lechenghhh/ContourLine/Software/FourTrekPerc/readme.md

#### 4组打击乐
可以通过四个触发输入接口来实现打击乐的输出
Perc oscillator  
base on Arduino nano 328p/168p  
for ContourLine 2.1  
作者: lecheng  
演示：https://www.bilibili.com/video/BV1vx4y1a7s7

### 音频接口:  

0.      a0:Pitch(对每个音色都有不同影响)  a1:Kick Trig  
1.      a2:Clap Trig                    a3:Tom Trig  
2.      d11:Hat Trig                    d9d10:AudioOut    

### 显示参数:  

 0.         8位数码管显示字母        参数名词EN                   参数名词CN                    参数说明
 1.         K                       Kick                        底鼓音量                      
 2.         P                       Tone                        底鼓音色
 3.         C                       Clap                        军鼓音量
 4.         F                       FreqCutoff                  军鼓截至频率                    
 5.         T                       Hat                         镲片音量                   
 6.         P                       Decay                       镲片衰减                    
 7.         H                       Rim                         小打音量                    
 8.         D                       Pitch                       小打音高
