lechenghhh/ContourLine/Hardware/v2.2 4HP/Readme.md

## Contourline2.2 4HP  
#### 更新说明  
1.改进布局与元件位号 更容易手焊 也容易排查错误  
2.优化led分压电阻封装为0603(上个版本是0402) 更容易买到也更容易焊接  
3.优化铺铜网格间隙为0.2  
4.增加-12v保护二极管 减少反接运放可能损坏情况
