lechenghhh/ContourLine/Software/FmAddChordDCO/org_change/readme.md

## 基于原版的chord/add/fm硬件与程序优化修改  
https://github.com/Testbild-synth/HAGIWO_arduino_oscillator
## 修改说明
修复p1 p2 cv输入颠倒的问题  
修复chord/add模式颠倒的问题  
优化fm算法  
优化基音为c0 使旋钮最小时不再无声
