lechenghhh/ContourLine/Hardware/v2.2 4HP/img/侧面.jpg

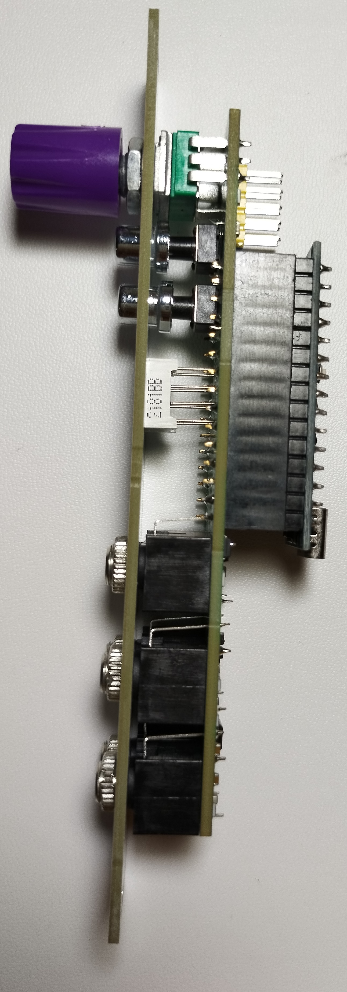
Hardware/v2.2 4HP/img/侧面.jpg
