lechenghhh/ContourLine/Hardware/v2.2 4HP/img/正面.png

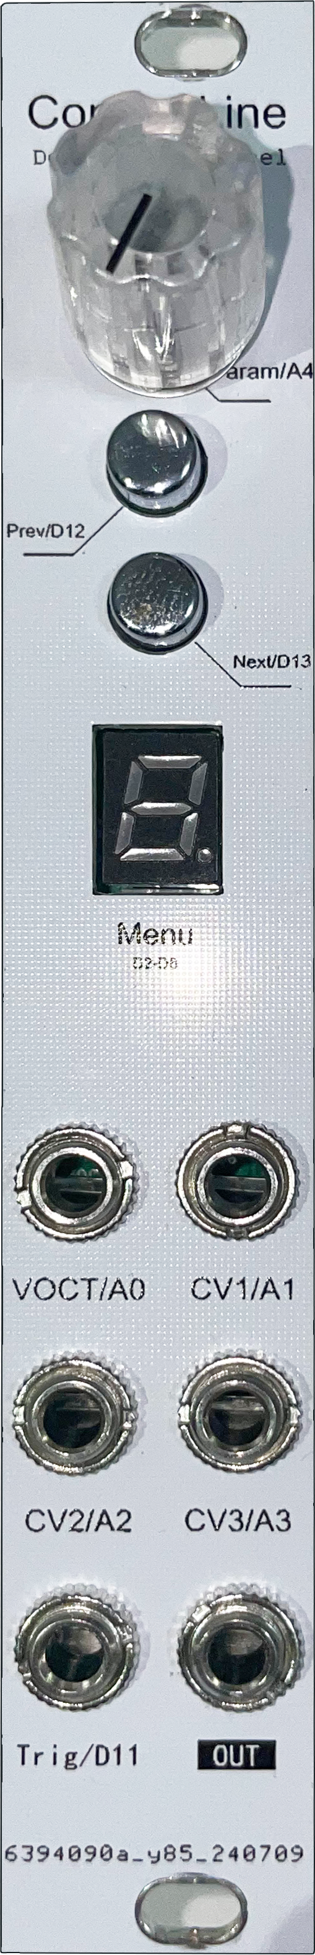
Hardware/v2.2 4HP/img/正面.png
