lechenghhh/ContourLine/Software/Avr-wt-synth/panel.png

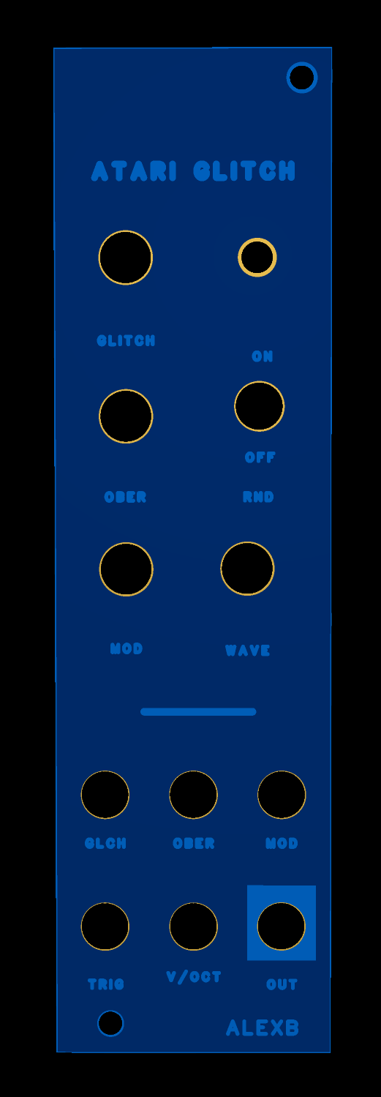
Software/Avr-wt-synth/panel.png
