lechenghhh/ContourLine/Hardware/v2.2 4HP/BOM_ContourLine2.2 4HP_ContourLine2.2 4HP_2024-07-29.xlsx

Quantity | Comment | Designator | Footprint | Value | Manufacturer Part | Primary Category | Secondary Category
1 | 100pF | C2 | R0805 | 100pF | 0805B472K500NT |  | Multilayer Ceramic Capacitors MLCC - SMD/SMT
6 | 4.7nF | C3,C4,C5,C6,C8,C11 | R0805 | 4.7nF | 0805B472K500NT | 注意 不要搞错 u和n | Multilayer Ceramic Capacitors MLCC - SMD/SMT
2 | 4.7uF | C10,C13 | R0805 | 4.7uF | 0805B472K500NT | 注意 搞错也没事就是 | Multilayer Ceramic Capacitors MLCC - SMD/SMT
10 | 1N5819 | D1,D2,D5,D6,D7,D8,D9,D10,D11,D12 | SOD-123_L2.7-W1.6-LS3.7-RD-1 | B5819W SL | B5819W SL | 二极管 | 肖特基二极管 注意封装是SOD-123
2 | 100Ω | R3,R12 | R0805 | 100Ω | 0805W8F1000T5E | Resistors | Chip Resistor - Surface Mount
5 | 470Ω | R7,R21,R104,R107,R108 | R0805 这里可以跟下面一起买0603的封装 | 470Ω | 0603WAF4700T5E | Resistors | Chip Resistor - Surface Mount
7 | 470Ω | R13,R14,R15,R16,R17,R18,R19 | R0603 | 470Ω | 0603WAF4700T5E | Resistors | Chip Resistor - Surface Mount
3 | 1kΩ | R8,R10,R11 | R0805 | 1kΩ | 0805W8F1001T5E | Resistors | Chip Resistor - Surface Mount
2 | 3.9kΩ | R1,R20 | R0805 | 3.9kΩ | 0603WAF3901T5E | Resistors | Chip Resistor - Surface Mount
1 | 47kΩ | R25 | R0805 | 47kΩ | 0805W8F4702T5E | Resistors | Chip Resistor - Surface Mount
5 | 100kΩ | R24,R101,R102,R103,R109 | R0805 | 100kΩ | 0805W8F1003T5E | Resistors | Chip Resistor - Surface Mount
1 | 330kΩ | R100 | R0805 | 330kΩ | 0603WAF3303T5E | Resistors | Chip Resistor - Surface Mount
3 | 499kΩ | R2,R105,R106 | R0805 | 499kΩ | 0805W8F1003T5E | Resistors | Chip Resistor - Surface Mount
2 | TS665CJ | U1,U2 | SW-TH_4P-L6.0-W6.0-P4.50-LS6.5 | 6x6微动开关 | TS665CJ | Key/Switch | Tactile Switches 柄选择长一些的 按钮帽可以搜索6x6 a56按钮帽 任何颜色都可以
1 | 100k | U3 | res-adj-th_rk097111080j | 10-100k 电位器都可以 | RK097111080J | Resistors | Variable Resistors/Potentiometers
1 | TL072CDT | U5 | SOIC-8_L5.0-W4.0-P1.27-LS6.0-BL | 运算放大器 | TL072CDT | 运算放大器/比较器 | FET输入运放 替代品 ne5532 lm358
6 | PJ-301f | AUDIOOUT2,CV1_A1,CV2_A2,CV3_A3,CV_OUT1,VOCT1_A0 | AUDIO-TH_PJ-301f | 音频插座 针脚 | PJ-301f | 连接器 | 音频连接器
1 | +12 | H11 | HDR-TH_10P-P2.54-V-M-R2-C5-S2.54 | 2x5p排针电源 | PZ254V-12-10P | 连接器 | 排针 2x5p排针 可以使用2个1x5p代替
1 | ARDUINO_NANO | I2 | COMM-TH_ARDUINO_NANO | 单片微控制器 | ARDUINO_NANO | 注意 需要配备排针排母 | 共约32p左右
1 | SLR0281DRA1BD | LED2 | LED-SEG-TH_8P-L7.4-W10.0-P2.54-S5.00-TL | 8位共阳数码管 | SLR0281DRA1BD | 数码管驱动/LED驱动 | LED数码管 https://item.taobao.com/item.htm?spm=a1z09.2.0.0.14a02e8dwHAgrf&id=35519235663&_u=tlnom7sc023
1 | 100nF | C9 非必要 | R0805 | 100nF 非必要 | CC0805KRX7R9BB104
 |  | 注意 电阻电容可以都买0603的
 |  | 他们仍然可以被焊接在0805的焊盘上
 |  | 也会比较容易焊接 | Note that both resistors and capacitors can be purchased from 0603, and they can still be soldered onto 0805 pads, which will also be easier to solder
