lechenghhh/ContourLine/Software/_Test/Pocket-Synth/README.md

# Pocket-Synth
Presets for a pocket sized Arduino synthesizer. Made heavy use of MOZZI library. Analog inputs were controlled by potentiometers.
