lechenghhh/ContourLine/Software/_Test/reFlector_v0.1/README.md

# reFlector
<h4>Arduino based synth and sequencer.</h4>

<em>WORK IN PROGRESS</em>

Uses primarily Mozzi library.

<br>
