lechenghhh/ContourLine/Software/_Test/FmDCOfor0.6/1位10脚数码管1.png

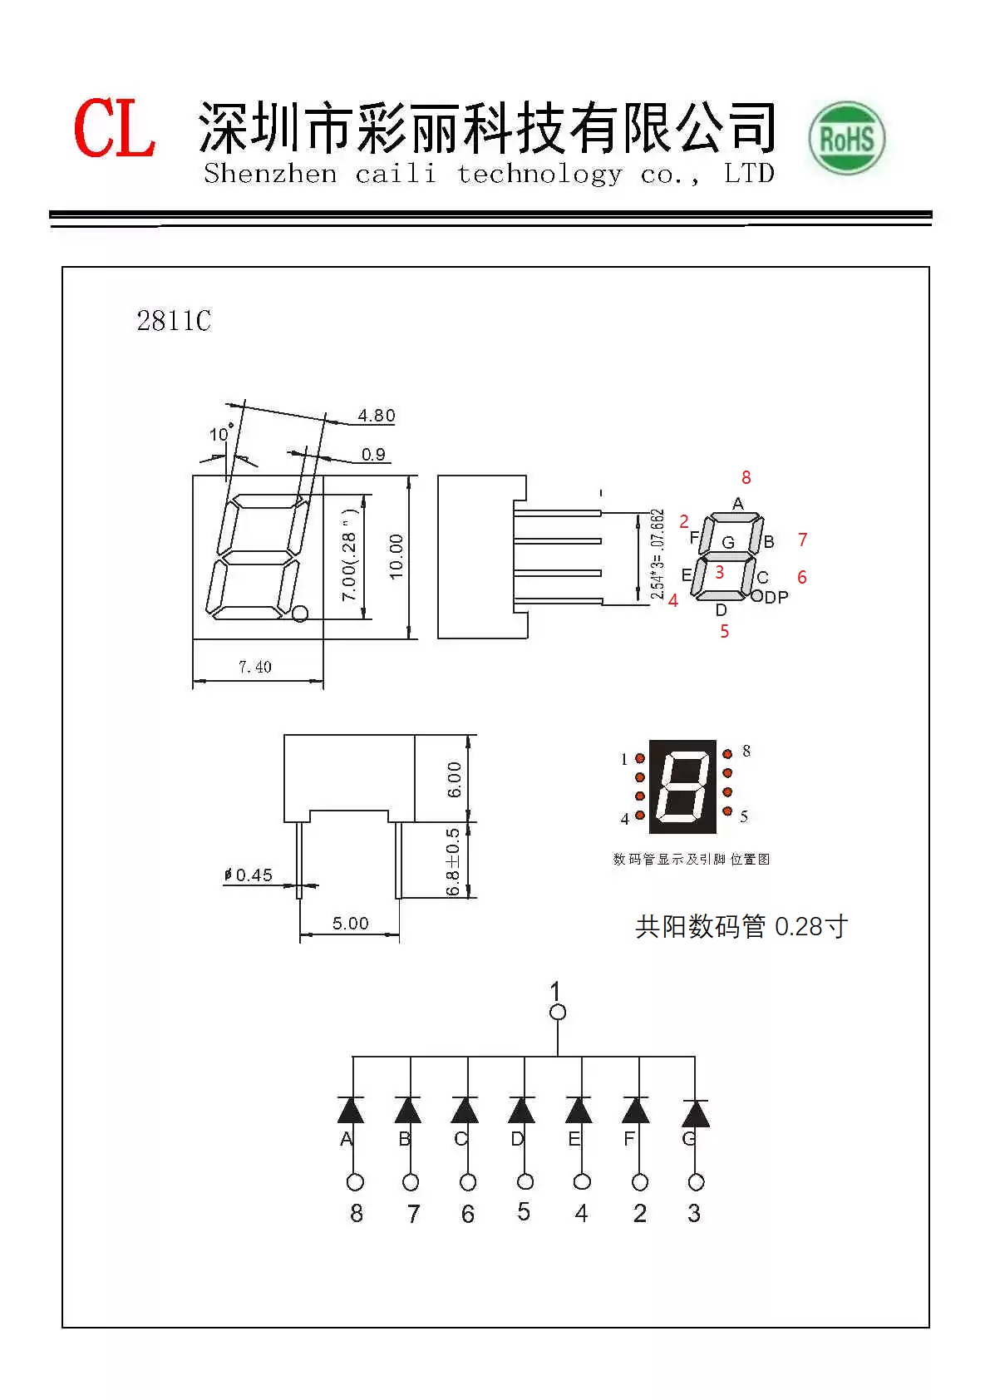
Software/_Test/FmDCOfor0.6/1位10脚数码管1.png
