lechenghhh/ContourLine/Software/_Test/pitch_covert_freq.jpg

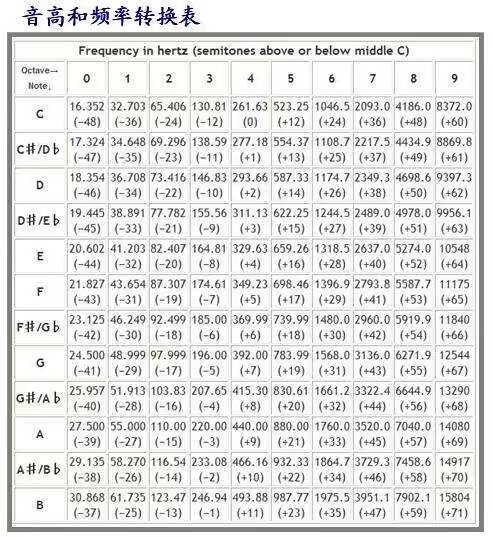
Software/_Test/pitch_covert_freq.jpg
