lechenghhh/ContourLine/Software/_Test/Test/FullFuncDCO/1bit 10pin.jpeg

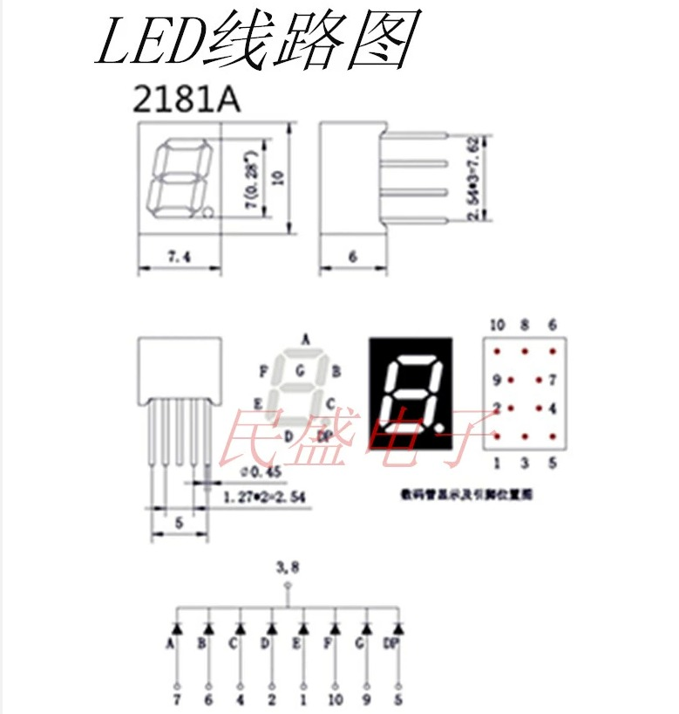
Software/_Test/Test/FullFuncDCO/1bit 10pin.jpeg
