lechenghhh/ContourLine/(threads)

Thread 1 (2024-07-04):

Trigger/Gate input: capacitor or resistor?

dlakwi, 2024-07-04:
In the v2.2 hardware design, the trigger/gate input has a capacitor C7 (100pF) from input to ground.
Shouldn't this be a resistor? Perhaps 100k?

lechenghhh, 2024-07-24:
You're right, if it's a larger resistor, it can serve as overcurrent protection

Closed 2024-07-31.
