lechenghhh/ContourLine/Software/FmAddChordDCO/FmAddChordDCO.ino

//https://github.com/Testbild-synth/HAGIWO_arduino_oscillator //项目地址
#include <Mozzi.h>
#include <Oscil.h>
#include <tables/sin2048_int8.h>
#include <tables/saw2048_int8.h>
#include <tables/triangle_hermes_2048_int8.h>
#include <tables/square_no_alias_2048_int8.h>
#include <tables/triangle_dist_cubed_2048_int8.h>
#include <FixMath.h>
#include "Module_Ctrl.h"
#include "Module_LEDDisplay.h"

#define CONTROL_RATE 64

#define V_OCT_PIN A0

// #define FREQ_PIN A0
// #define P1_POT_PIN A1
// #define P2_POT_PIN A3

#define P1_CV_PIN A1
#define P2_CV_PIN A2
// #define GAIN_CV_PIN A6
#define MODE_CV_PIN A3

#define SW_PIN_1 4
#define SW_PIN_2 5
#define LED_1_PIN 6
#define LED_2_PIN 7
#define LED_3_PIN 8
#define PARAM_LENGTH 5  // menu length

Oscil<SIN2048_NUM_CELLS, AUDIO_RATE> osc1(SIN2048_DATA);
Oscil<SIN2048_NUM_CELLS, AUDIO_RATE> osc2(SIN2048_DATA);
Oscil<SIN2048_NUM_CELLS, AUDIO_RATE> osc3(SIN2048_DATA);
Oscil<SIN2048_NUM_CELLS, AUDIO_RATE> osc4(SIN2048_DATA);
Oscil<SIN2048_NUM_CELLS, AUDIO_RATE> osc5(SIN2048_DATA);
Oscil<SIN2048_NUM_CELLS, AUDIO_RATE> osc6(SIN2048_DATA);
Oscil<SIN2048_NUM_CELLS, AUDIO_RATE> osc7(SIN2048_DATA);
Oscil<SIN2048_NUM_CELLS, AUDIO_RATE> osc8(SIN2048_DATA);

int btnHover3 = 0;  //按下事件判断
int btnTime3 = 0;   //长按事件判断

uint16_t freq_pot_val = 0;  //频率旋钮
uint16_t oct_cv_val = 0;    //voct cv
uint16_t p1_pot_val = 0;
uint16_t p1_cv_val = 0;
uint16_t p2_pot_val = 0;
uint16_t p2_cv_val = 0;
int gain_cv_val = 0;
uint8_t mode = 0;
uint8_t md_val = 0;

///additive variables
int ADD_freq1 = 110;   //base freq of OSC1
int ADD_freqv1 = 440;  // freq1 apply voct
byte ADD_gain = 127;
uint8_t ADD_harm_knob = 0;
int g1;
int g2;
int g3;
int g4;
int g5;
int g6;
int g7;
int g8;
////////

////chord variables
int freq1 = 110;  //base freq

int freqv1 = 440;  //apply voct
int freqv2 = 440;
int freqv3 = 440;
int freqv4 = 440;
int freqv5 = 440;

byte note1 = 0;  //Root
byte note2 = 0;  //2nd
byte note3 = 0;  //3rd
byte note4 = 0;  //4th
byte note5 = 0;  //Root

byte inv_aply1 = 0;  //0 = no inv , 1 = inv , Root
byte inv_aply2 = 0;  //2nd
byte inv_aply3 = 0;  //3rd
byte inv_aply4 = 0;  //4th
bool inv_aply5 = 0;  //0 = no output root sound , 1 = output root sound

int inv = 0;
int inv_knob = 0;
int chord = 0;
byte wave = 0;
////////

////FM variables
Q16n16 fm_deviation;  //偏离
Q16n16 mod_freq, knob_freq;
///////

const static byte chord_table[8][4] PROGMEM = {
  {
    0,
    68,
    119,
    205,
  },  //Maj
  {
    0,
    68,
    119,
    187,
  },  //Maj7
  {
    0,
    68,
    119,
    239,
  },  //Majadd9
  {
    0,
    34,
    119,
    205,
  },  //sus2
  {
    0,
    51,
    119,
    239,
  },  //minadd9
  {
    0,
    51,
    119,
    170,
  },  //min7
  {
    0,
    51,
    119,
    205,
  },  //min
  {
    0,
    0,
    0,
    0,
  }  //root
};

const static float voctpow[1024] PROGMEM = {
  0, 0.004882, 0.009765, 0.014648, 0.019531, 0.024414, 0.029296, 0.034179, 0.039062, 0.043945, 0.048828, 0.05371, 0.058593, 0.063476, 0.068359, 0.073242, 0.078125, 0.083007, 0.08789, 0.092773, 0.097656, 0.102539, 0.107421, 0.112304, 0.117187, 0.12207, 0.126953, 0.131835, 0.136718, 0.141601, 0.146484, 0.151367, 0.15625,
  0.161132, 0.166015, 0.170898, 0.175781, 0.180664, 0.185546, 0.190429, 0.195312, 0.200195, 0.205078, 0.20996, 0.214843, 0.219726, 0.224609, 0.229492, 0.234375, 0.239257, 0.24414, 0.249023, 0.253906, 0.258789, 0.263671, 0.268554, 0.273437, 0.27832, 0.283203, 0.288085, 0.292968, 0.297851, 0.302734, 0.307617, 0.3125, 0.317382,
  0.322265, 0.327148, 0.332031, 0.336914, 0.341796, 0.346679, 0.351562, 0.356445, 0.361328, 0.36621, 0.371093, 0.375976, 0.380859, 0.385742, 0.390625, 0.395507, 0.40039, 0.405273, 0.410156, 0.415039, 0.419921, 0.424804, 0.429687, 0.43457, 0.439453, 0.444335, 0.449218, 0.454101, 0.458984, 0.463867, 0.46875, 0.473632, 0.478515,
  0.483398, 0.488281, 0.493164, 0.498046, 0.502929, 0.507812, 0.512695, 0.517578, 0.52246, 0.527343, 0.532226, 0.537109, 0.541992, 0.546875, 0.551757, 0.55664, 0.561523, 0.566406, 0.571289, 0.576171, 0.581054, 0.585937, 0.59082, 0.595703, 0.600585, 0.605468, 0.610351, 0.615234, 0.620117, 0.625, 0.629882, 0.634765, 0.639648,
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
  { 2, 2, 2, 2, 2, 2, 2, 2, 2, 2, 2, 3, 3, 3, 4, 4, 4, 4, 5, 5, 6, 6, 7, 7, 8, 8, 8, 8, 10, 10, 10, 12, 12, 14, 14, 14, 15, 15, 15, 15, 15, 15, 16, 16, 16, 16, 16, 15, 15, 15, 15, 15, 15, 14, 14, 14, 12, 12, 10, 10, 10, 8, 8, 8, 8, 7, 7, 6, 6, 5, 5, 4, 4, 4, 4, 3, 3, 3, 2, 2, 2, 2, 2, 2, 2, 2, 2, 2, 2, 2, 2, 2, 2, 2, 2, 2, 2, 2, 2, 2, 2, 3, 3, 3, 4, 4, 4, 4, 5, 5, 6, 6, 7, 7, 8, 8, 8, 8, 10, 10, 10, 12, 12, 14, 14, 14, 15, 15, 15, 15, 15, 15, 16, 16, 16, 16, 16, 16, 15, 15, 15, 15, 15, 14, 14, 14, 12, 12, 12, 10, 10, 8, 8, 8, 8, 7, 7, 6, 6, 5, 5, 4, 4, 4, 4, 3, 3, 3, 2, 2, 2, 2, 2, 2, 2, 2, 2, 2, 2, 2, 2, 2, 2, 2, 2, 2, 2, 2, 2, 2, 2, 3, 3, 3, 4, 4, 4, 4, 5, 5, 6, 6, 7, 7, 8, 8, 8, 8, 10, 10, 10, 12, 12, 14, 14, 14, 15, 15, 15, 15, 15, 15, 16, 16, 16, 16, 16, 16, 15, 15, 15, 15, 15, 14, 14, 14, 12, 12, 12, 10, 10, 8, 8, 8, 8, 7, 7, 6, 6, 5, 5, 4, 4, 4, 4, 3 },
  { 2, 2, 2, 2, 3, 3, 3, 4, 4, 4, 4, 4, 4, 5, 5, 6, 6, 6, 7, 7, 8, 8, 8, 8, 8, 10, 10, 10, 12, 12, 14, 14, 14, 15, 15, 15, 15, 16, 16, 16, 16, 16, 16, 16, 16, 16, 16, 16, 16, 16, 16, 16, 16, 16, 16, 16, 16, 16, 16, 16, 16, 16, 15, 15, 15, 15, 14, 14, 14, 12, 12, 12, 10, 10, 8, 8, 8, 8, 8, 7, 7, 6, 6, 6, 5, 5, 4, 4, 4, 4, 4, 4, 3, 3, 3, 2, 2, 2, 2, 2, 2, 2, 2, 2, 2, 2, 2, 2, 2, 2, 2, 2, 2, 2, 2, 2, 2, 2, 2, 2, 2, 2, 2, 2, 3, 3, 3, 4, 4, 4, 4, 4, 4, 5, 5, 6, 6, 6, 7, 7, 8, 8, 8, 8, 8, 10, 10, 10, 12, 12, 14, 14, 14, 15, 15, 15, 15, 16, 16, 16, 16, 16, 16, 16, 16, 16, 16, 16, 16, 16, 16, 16, 16, 16, 16, 16, 16, 16, 16, 16, 16, 16, 16, 15, 15, 15, 14, 14, 14, 12, 12, 12, 10, 10, 8, 8, 8, 8, 8, 7, 7, 6, 6, 6, 5, 5, 4, 4, 4, 4, 4, 4, 3, 3, 3, 2, 2, 2, 2, 2, 2, 2, 2, 2, 2, 2, 2, 2, 2, 2, 2, 2, 2, 2, 2, 2, 2, 2, 2, 2, 2, 2, 2, 2, 3, 3, 3, 3, 4, 4, 4, 4, 4, 5, 5, 6 }
};

byte POSITION = 0;
char param_name[PARAM_LENGTH][5] = { "Freq", "P1", "P2", "Mode", "WaveT" };
short param[PARAM_LENGTH] = { 0, 0, 0, 0, 0 };
bool* ledGroup[PARAM_LENGTH] = { Led_F, Led_1, Led_2, Led_M, Led_W };

void setup() {
  // Serial.begin(115200);  //使用Serial.begin()函数来初始化串口波特率,参数为要设置的波特率
  startMozzi(CONTROL_RATE);
  pinMode(LED_1_PIN, OUTPUT);
  pinMode(LED_2_PIN, OUTPUT);
  pinMode(LED_3_PIN, OUTPUT);
  pinMode(SW_PIN_1, INPUT_PULLUP);
  pinMode(SW_PIN_2, INPUT_PULLUP);
  digitalWrite(SW_PIN_1, HIGH);
  digitalWrite(SW_PIN_2, HIGH);

  initCtrl(4, 50, 12, 13, HIGH);  //初始化控制参数// 旋钮 旋钮修改启动范围 按钮1 按钮2
  pinMode(2, OUTPUT);
  pinMode(3, OUTPUT);
  pinMode(4, OUTPUT);
  pinMode(5, OUTPUT);
  pinMode(6, OUTPUT);
  pinMode(7, OUTPUT);
  pinMode(8, OUTPUT);
  pinMode(11, INPUT);
  digitalWrite(11, LOW);

  osc1.setTable(SIN2048_DATA);
  osc2.setTable(SIN2048_DATA);
  osc3.setTable(SIN2048_DATA);
  osc4.setTable(SIN2048_DATA);
  osc5.setTable(SIN2048_DATA);
  osc6.setTable(SIN2048_DATA);
  osc7.setTable(SIN2048_DATA);
  osc8.setTable(SIN2048_DATA);
}

void updateControl() {
  POSITION = getPostition(POSITION, PARAM_LENGTH);  //获取菜单下标
  param[POSITION] = getParam(param[POSITION]);     //用以注册按钮旋钮控制引脚 并获取修改成功的旋钮值
  displayLED(ledGroup[POSITION]);                  //display  //用字母展示控制
  if (getKnobEnable() == 0) displayLED(Led_NULL);  //如果处在非编辑状态 led将半灭显示

  // Serial.print(" mode=");           //mode 0: FM mode 1: add, mode 2: chord
  // Serial.print(mode);               //mode
  // Serial.print(" func");            //func param
  // Serial.print(POSITION);           //func param
  // Serial.print("=");                //func param
  // Serial.println(param[POSITION]);  //func param

  read_inputs();
  mode = param[3] >> 8;  // mode 0: FM mode 1: add, mode 2: chord

  // if (p1_pot_val >= 1020) {  //inv knob max
  set_waves();
  // } else {
  if (mode == 0) {
    knob_freq = freq_pot_val;
    FM_setFreqs(knob_freq);
  } else if (mode == 1) {
    ADD_setFreqs();
  } else {
    CHORD_setFreqs();
  }
  // }
}

void read_inputs() {
  // freq_pot_val = mozziAnalogRead(FREQ_PIN);
  freq_pot_val = param[0];
  oct_cv_val = mozziAnalogRead(V_OCT_PIN);
  // p1_pot_val = mozziAnalogRead(P1_POT_PIN);
  p1_pot_val = param[1];
  p1_cv_val = mozziAnalogRead(P1_CV_PIN);
  // p2_pot_val = mozziAnalogRead(P2_POT_PIN);
  p2_pot_val = param[2];
  p2_cv_val = mozziAnalogRead(P2_CV_PIN);
  // gain_cv_val = constrain(param[3] / 2, 0, 255);
  gain_cv_val = 255;
  md_val = mozziAnalogRead(MODE_CV_PIN) / 100;
}

//
void set_waves() {
  // switch (round(p2_pot_val / 200) - 1) {
  switch (param[4] >> 7) {
    default:  //sin
      osc1.setTable(SIN2048_DATA);
      osc2.setTable(SIN2048_DATA);
      osc3.setTable(SIN2048_DATA);
      osc4.setTable(SIN2048_DATA);
      osc5.setTable(SIN2048_DATA);
      osc6.setTable(SIN2048_DATA);
      osc7.setTable(SIN2048_DATA);
      osc8.setTable(SIN2048_DATA);
      break;

    case 1:  //tri hermes
      osc1.setTable(TRIANGLE_HERMES_2048_DATA);
      osc2.setTable(TRIANGLE_HERMES_2048_DATA);
      osc3.setTable(TRIANGLE_HERMES_2048_DATA);
      osc4.setTable(TRIANGLE_HERMES_2048_DATA);
      osc5.setTable(TRIANGLE_HERMES_2048_DATA);
      osc6.setTable(TRIANGLE_HERMES_2048_DATA);
      osc7.setTable(TRIANGLE_HERMES_2048_DATA);
      osc8.setTable(TRIANGLE_HERMES_2048_DATA);
      break;

    case 2:  //tri dist
      osc1.setTable(TRIANGLE_DIST_CUBED_2048_DATA);
      osc2.setTable(TRIANGLE_DIST_CUBED_2048_DATA);
      osc3.setTable(TRIANGLE_DIST_CUBED_2048_DATA);
      osc4.setTable(TRIANGLE_DIST_CUBED_2048_DATA);
      osc5.setTable(TRIANGLE_DIST_CUBED_2048_DATA);
      osc6.setTable(TRIANGLE_DIST_CUBED_2048_DATA);
      osc7.setTable(TRIANGLE_DIST_CUBED_2048_DATA);
      osc8.setTable(TRIANGLE_DIST_CUBED_2048_DATA);
      break;

    case 3:  //saw
      osc1.setTable(SAW2048_DATA);
      osc2.setTable(SAW2048_DATA);
      osc3.setTable(SAW2048_DATA);
      osc4.setTable(SAW2048_DATA);
      osc5.setTable(SAW2048_DATA);
      osc6.setTable(SAW2048_DATA);
      osc7.setTable(SAW2048_DATA);
      osc8.setTable(SAW2048_DATA);
      break;

    case 4:  //square
      osc1.setTable(SQUARE_NO_ALIAS_2048_DATA);
      osc2.setTable(SQUARE_NO_ALIAS_2048_DATA);
      osc3.setTable(SQUARE_NO_ALIAS_2048_DATA);
      osc4.setTable(SQUARE_NO_ALIAS_2048_DATA);
      osc5.setTable(SQUARE_NO_ALIAS_2048_DATA);
      osc6.setTable(SQUARE_NO_ALIAS_2048_DATA);
      osc7.setTable(SQUARE_NO_ALIAS_2048_DATA);
      osc8.setTable(SQUARE_NO_ALIAS_2048_DATA);
      break;
  }
}

void FM_setFreqs(Q16n16 freq2) {  //freq2=knob_freq
  // Serial.print("freq2 ");
  // Serial.println(freq2);

  Q16n16 toneFreq = (2270658 + freq2 * 5000) * pow(2, (pgm_read_float(&(voctpow[oct_cv_val]))));
  // mod_freq = ((toneFreq >> 8) * ((p1_pot_val + p1_cv_val) / 2));
  // fm_deviation = (p2_pot_val + p2_cv_val) << 6;
  // osc1.setFreq_Q16n16(toneFreq);
  // osc2.setFreq_Q16n16(mod_freq);
  mod_freq = (toneFreq >> 1) * ((p1_pot_val + p1_cv_val) >> 5);      //新版倍频算法 0.5-16倍频
  fm_deviation = ((mod_freq >> 16) * (1 + p2_pot_val + p2_cv_val));  //op2amount
  osc1.setFreq_Q16n16(toneFreq);                                     //给主波形设置频率
  osc2.setFreq_Q16n16(mod_freq);
}

void ADD_setFreqs() {
  //harmonics
  // ADD_harm_knob = constrain(((p2_pot_val + p2_cv_val) / 4), 0, 255);
  ADD_harm_knob = (p2_pot_val + p2_cv_val) / 16;
  //harmonics_gain
  // ADD_gain = constrain(((p1_cv_val + p1_pot_val) / 4), 0, 255);
  ADD_gain = (p1_cv_val + p1_pot_val) / 16;
  //OSC frequency knob
  ADD_freq1 = freq_pot_val / 8;
  ADD_freqv1 = ADD_freq1 * pow(2, (pgm_read_float(&(voctpow[oct_cv_val]))));  // V/oct apply

  osc1.setFreq(ADD_freqv1);  // set the frequency
  osc2.setFreq(ADD_freqv1 * (pgm_read_byte(&(ADD_harm_table[0][ADD_harm_knob]))));
  osc3.setFreq(ADD_freqv1 * (pgm_read_byte(&(ADD_harm_table[1][ADD_harm_knob]))));
  osc4.setFreq(ADD_freqv1 * (pgm_read_byte(&(ADD_harm_table[2][ADD_harm_knob]))));
  osc5.setFreq(ADD_freqv1 * (pgm_read_byte(&(ADD_harm_table[3][ADD_harm_knob]))));
  osc6.setFreq(ADD_freqv1 * (pgm_read_byte(&(ADD_harm_table[4][ADD_harm_knob]))));
  osc7.setFreq(ADD_freqv1 * (pgm_read_byte(&(ADD_harm_table[5][ADD_harm_knob]))));
  osc8.setFreq(ADD_freqv1 * (pgm_read_byte(&(ADD_harm_table[6][ADD_harm_knob]))));

  g1 = (pgm_read_byte(&(ADD_gain_table[0][ADD_gain])) / 8);
  g2 = (pgm_read_byte(&(ADD_gain_table[1][ADD_gain])) / 8);
  g3 = (pgm_read_byte(&(ADD_gain_table[2][ADD_gain])) / 8);
  g4 = (pgm_read_byte(&(ADD_gain_table[3][ADD_gain])) / 8);
  g5 = (pgm_read_byte(&(ADD_gain_table[4][ADD_gain])) / 8);
  g6 = (pgm_read_byte(&(ADD_gain_table[5][ADD_gain])) / 8);
  g7 = (pgm_read_byte(&(ADD_gain_table[6][ADD_gain])) / 8);
  g8 = (pgm_read_byte(&(ADD_gain_table[7][ADD_gain])) / 8);
}

void CHORD_setFreqs() {
  chord = constrain((p2_pot_val / 128) + (p2_cv_val / 128), 0, 7);

  //inversion setting
  inv = constrain((p1_pot_val / 64) + (p1_cv_val / 64), 0, 15);
  switch (inv) {
    case 0:
      inv_aply1 = 0;
      inv_aply2 = 0;
      inv_aply3 = 0;
      inv_aply4 = 0;
      inv_aply5 = 0;
      break;

    case 1:
      inv_aply1 = 1;
      inv_aply2 = 0;
      inv_aply3 = 0;
      inv_aply4 = 0;
      inv_aply5 = 0;
      break;

    case 2:
      inv_aply1 = 1;
      inv_aply2 = 1;
      inv_aply3 = 0;
      inv_aply4 = 0;
      inv_aply5 = 0;
      break;

    case 3:
      inv_aply1 = 1;
      inv_aply2 = 1;
      inv_aply3 = 1;
      inv_aply4 = 0;
      inv_aply5 = 0;
      break;

    case 4:
      inv_aply1 = 1;
      inv_aply2 = 1;
      inv_aply3 = 1;
      inv_aply4 = 1;
      inv_aply5 = 0;
      break;

    case 5:
      inv_aply1 = 2;
      inv_aply2 = 1;
      inv_aply3 = 1;
      inv_aply4 = 1;
      inv_aply5 = 0;
      break;

    case 6:
      inv_aply1 = 2;
      inv_aply2 = 2;
      inv_aply3 = 1;
      inv_aply4 = 1;
      inv_aply5 = 0;
      break;

    case 7:
      inv_aply1 = 2;
      inv_aply2 = 2;
      inv_aply3 = 2;
      inv_aply4 = 1;
      inv_aply5 = 0;
      break;

    case 8:
      inv_aply1 = 2;
      inv_aply2 = 2;
      inv_aply3 = 2;
      inv_aply4 = 1;
      inv_aply5 = 1;
      break;

    case 9:
      inv_aply1 = 2;
      inv_aply2 = 2;
      inv_aply3 = 1;
      inv_aply4 = 1;
      inv_aply5 = 1;
      break;

    case 10:
      inv_aply1 = 2;
      inv_aply2 = 1;
      inv_aply3 = 1;
      inv_aply4 = 1;
      inv_aply5 = 1;
      break;

    case 11:
      inv_aply1 = 1;
      inv_aply2 = 1;
      inv_aply3 = 1;
      inv_aply4 = 1;
      inv_aply5 = 1;
      break;

    case 12:
      inv_aply1 = 1;
      inv_aply2 = 1;
      inv_aply3 = 1;
      inv_aply4 = 0;
      inv_aply5 = 1;
      break;

    case 13:
      inv_aply1 = 1;
      inv_aply2 = 1;
      inv_aply3 = 0;
      inv_aply4 = 0;
      inv_aply5 = 1;
      break;

    case 14:
      inv_aply1 = 1;
      inv_aply2 = 0;
      inv_aply3 = 0;
      inv_aply4 = 0;
      inv_aply5 = 1;
      break;

    case 15:
      inv_aply1 = 0;
      inv_aply2 = 0;
      inv_aply3 = 0;
      inv_aply4 = 0;
      inv_aply5 = 1;
      break;
  }
  //setting chord note
  note1 = (pgm_read_byte(&(chord_table[chord][0])));
  note2 = (pgm_read_byte(&(chord_table[chord][1])));
  note3 = (pgm_read_byte(&(chord_table[chord][2])));
  note4 = (pgm_read_byte(&(chord_table[chord][3])));
  note5 = (pgm_read_byte(&(chord_table[chord][0])));
  //OSC frequency knob
  freq1 = freq_pot_val / 4 + 65;
  //set wave
  if (p1_pot_val >= 1020) {  //inv knob max
    wave = (p2_pot_val / 128);
  }
  freqv1 = freq1 * pow(2, (pgm_read_float(&(voctpow[oct_cv_val + 205 * inv_aply1 + note1]))));  //ROOT
  freqv2 = freq1 * pow(2, (pgm_read_float(&(voctpow[oct_cv_val + 205 * inv_aply2 + note2]))));  //2nd
  freqv3 = freq1 * pow(2, (pgm_read_float(&(voctpow[oct_cv_val + 205 * inv_aply3 + note3]))));  //3rd
  freqv4 = freq1 * pow(2, (pgm_read_float(&(voctpow[oct_cv_val + 205 * inv_aply4 + note4]))));  //4th
  freqv5 = freq1 * pow(2, (pgm_read_float(&(voctpow[oct_cv_val + note5]))));                    //ROOT
  osc1.setFreq(freqv1);                                                                         // set the frequency
  osc2.setFreq(freqv2);
  osc3.setFreq(freqv3);
  osc4.setFreq(freqv4);
  osc5.setFreq(freqv5);
}


AudioOutput_t updateAudio() {
  if (mode == 0) {  //fm
    // return MonoOutput::fromNBit(16, (osc1.phMod(Q15n16(fm_deviation * osc2.next() >> 8)) / 2) * (gain_cv_val / 2));//old
    return MonoOutput::fromNBit(16, osc1.phMod(fm_deviation * osc2.next() >> 8) << 8);  //new
  } else if (mode == 1) {  //add   // return MonoOutput::fromNBit(16, (osc1.next() * (pgm_read_byte(&(ADD_gain_table[0][ADD_gain]))) / 512 + osc2.next() * (pgm_read_byte(&(ADD_gain_table[1][ADD_gain]))) / 512 + osc3.next() * (pgm_read_byte(&(ADD_gain_table[2][ADD_gain]))) / 512 + osc4.next() * (pgm_read_byte(&(ADD_gain_table[3][ADD_gain]))) / 512 + osc5.next() * (pgm_read_byte(&(ADD_gain_table[4][ADD_gain]))) / 512 + osc6.next() * (pgm_read_byte(&(ADD_gain_table[5][ADD_gain]))) / 512 + osc7.next() * (pgm_read_byte(&(ADD_gain_table[6][ADD_gain]))) / 512 + osc8.next() * (pgm_read_byte(&(ADD_gain_table[7][ADD_gain]))) / 512) * (gain_cv_val / 4));
    int as1 = osc1.next() * g1;
    int as2 = osc2.next() * g2;
    int as3 = osc3.next() * g3;
    int as4 = osc4.next() * g4;
    int as5 = osc5.next() * g5;
    int as6 = osc6.next() * g6;
    int as7 = osc7.next() * g7;
    int as8 = osc8.next() * g8;
    return MonoOutput::fromNBit(16, (as1 + as2 + as3 + as4 + as5 + as6 + as7 + as8));
  } else {  //chord
    return MonoOutput::fromNBit(16, ((osc1.next() / 8 + osc2.next() / 8 + osc3.next() / 8 + osc4.next() / 8 + osc5.next() / 8 * inv_aply5) * gain_cv_val));
  }
}

void loop() {
  audioHook();
}
