lechenghhh/ContourLine/Software/AnalogWave/Module_Ctrl.h

/*
  电位器 按钮 控制功能
*/

int KNOB;
int BTN1;
int BTN2;
int KNOB_CHANGE_RANGE;
int DEF_LV;

int btnHover1 = 0;   //按下事件判断1
int btnTime1 = 0;    //长按事件判断1
int btnHover2 = 0;   //按下事件判断2
int btnTime2 = 0;    //长按事件判断2
int knobEnable = 0;  //旋钮编辑状态

/*
  konbPin           旋钮模拟引脚
  konbChangeRange   旋钮启用改变的差值
  btn1Pin           按钮1数字引脚
  btn2Pin           按钮2数字引脚
  default_level     按钮默认电平
*/
void initCtrl(int konbPin, int konbChangeRange, int btn1Pin, int btn2Pin, int default_level) {
  pinMode(11, INPUT);
  digitalWrite(11, LOW);
  KNOB = konbPin;
  KNOB_CHANGE_RANGE = konbChangeRange;
  BTN1 = btn1Pin;
  BTN2 = btn2Pin;
  DEF_LV = default_level;
  if (DEF_LV == 1) {
    // pinMode(BTN2, INPUT_PULLUP);//D13引脚会因为无法上拉电阻而导致无法默认高电平 因此手动设置
    if (BTN1 == 13) digitalWrite(BTN1, HIGH);
    else pinMode(BTN1, INPUT_PULLUP);
    if (BTN2 == 13) digitalWrite(BTN2, HIGH);
    else pinMode(BTN2, INPUT_PULLUP);
  } else {
    pinMode(BTN1, INPUT);
    pinMode(BTN2, INPUT);
  }
}

/*
  传入菜单下标
  返回经过控制逻辑处理后的下标
*/
int getPostition(int position, int functionLength) {
  // Serial.println(mozziAnalogRead(KNOB));   //knob
  // Serial.println(digitalRead(BTN1));  //btn1
  // Serial.println(digitalRead(BTN2));  //btn2
  // Serial.println(btnHover1);   //btn2
  // Serial.println(btnTime1);    //btn2

  //按下事件
  if (digitalRead(BTN1) != DEF_LV) {
    btnHover1 = 1;
    btnTime1++;
  } else if (digitalRead(BTN2) != DEF_LV) {
    btnHover2 = 1;
    btnTime2++;
  }
  //抬起事件
  if (digitalRead(BTN1) == DEF_LV && btnHover1 == 1) {
    //长按按钮事件
    if (btnTime1 > 50) {
      position = 0;
      Serial.println("btn long");  //knob
    }
    //短按按钮事件
    else {
      if (position <= 0) {
        position = functionLength;
      }
      position--;
      Serial.println("btn short");  //knob
    }
    btnHover1 = 0;
    btnTime1 = 0;
    knobEnable = 0;
    Serial.println(knobEnable);  //btn2
  } else if (digitalRead(BTN2) == DEF_LV && btnHover2 == 1) {
    //长按按钮事件
    if (btnTime2 > 50) {
      position = 0;
      Serial.println("btn long 2");  //knob
    }
    //短按按钮事件
    else {
      if (functionLength - 1 <= position) {
        position = -1;
      }
      position++;
      Serial.println("btn short 2");  //knob
    }
    btnHover2 = 0;
    btnTime2 = 0;
    knobEnable = 0;
    Serial.println(knobEnable);  //btn2
  }
  return position;
}

int myread(int pin) {
  // return mozziAnalogRead(pin) / 4;  //if lgt8f328p
  return mozziAnalogRead(pin);  // if arduino nano
}

/*
  根据旧的值传入该方法判断旋钮编辑状态来返回新修改的值
*/
int getParam(int old_param) {
  // Serial.print(knobEnable);   //btn2
  // Serial.println(old_param);  //btn2
  // Serial.print("   mozziAnalogRead(KNOB) ");  //btn2
  // Serial.println(mozziAnalogRead(KNOB));      //btn2
  //旋钮事件
  int knob_dec = myread(KNOB) - old_param;  // if arduino nano  //检测旋钮进入原参数范围
  if (-KNOB_CHANGE_RANGE < knob_dec && knob_dec < KNOB_CHANGE_RANGE) {
    knobEnable = 1;
  }
  if (knobEnable == 1) {  //进入范围后 则可以调节当前参数
    old_param = myread(KNOB);
  }
  return old_param;
}

/*
  获取旋钮是否处于编辑状态 以便视图进行显示操作
*/
int getKnobEnable() {
  return knobEnable;
}
