lechenghhh/ContourLine/Software/Sampler/mysample1.h

#ifndef BAMBOO_00_4096_H_
#define BAMBOO_00_4096_H_

#include <Arduino.h>
#include "mozzi_pgmspace.h"

#define BAMBOO_00_4096_NUM_CELLS 4096
#define BAMBOO_00_4096_SAMPLERATE 16384

CONSTTABLE_STORAGE(int8_t) mysample1_DATA []  = {-1, 0, -1, 0, -1, 0, 1, 0, 0, 0, -1,
                1, 0, 0, 2, -2, -21, -66, -98, -56, 37, 60, 1, -31, 7, 72, 95, 90, 63, -1, -44,
                -72, -89, -28, 59, 92, 60, -12, -86, -125, -102, -32, 66, 123, 69, -19, -53,
                -61, -58, -20, 31, 74, 72, 6, -58, -65, -38, -9, 36, 69, 63, 22, -47, -78, -40,
                7, 36, 55, 55, 28, -22, -50, -15, 21, 21, 12, 10, 20, 12, -31, -49, -27, 0, 12,
                17, 18, 12, -16, -46, -40, -9, 9, 8, 3, 14, 9, -24, -37, -18, 2, 15, 20, 25, 28,
                4, -31, -38, -13, 19, 35, 34, 25, 4, -24, -32, -14, 21, 38, 27, 12, -3, -30,
                -48, -30, 7, 30, 28, 6, -14, -32, -41, -28, 5, 31, 28, 0, -28, -32, -22, -10, 3,
                20, 21, 2, -13, -9, 1, 5, 7, 12, 15, 10, 0, -1, 9, 11, 5, -1, 3, 13, 12, 5, 0,
                -1, -4, -10, -9, 2, 8, 5, 0, -8, -18, -24, -19, 0, 14, 10, -11, -28, -27, -16,
                -3, 8, 19, 15, 0, -14, -14, -4, 6, 14, 19, 16, 2, -14, -12, 0, 13, 20, 21, 16,
                4, -3, -5, 0, 7, 9, 2, -6, -9, -10, -10, -5, -1, -3, -8, -12, -13, -9, -8, -7,
                -4, -4, -7, -7, -4, 0, -1, -6, -8, -4, 4, 6, 6, 8, 6, 2, 2, 6, 10, 11, 14, 14,
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
-2, -3, -3, -11, -19, -18, -13, -1, 8, 10, 3, 0, -7, -5, 1, 8, 11, 15, 13, 5,
-4, -5, -1, 9, 16, 16, 12, 2, -5, -9, -4, 2, 5, 5, -1, -8, -13, -14, -13, -8, 1,
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
                                           };

#endif /* BAMBOO_00_4096_H_ */
