lechenghhh/ContourLine/Software/_Test/Test/EGFilter/EGFilter.ino

//主程序 逻辑
#include <MozziGuts.h>

#include "Module_LEDDisplay.h"  //自定义库封装led 控制 常量
#include "Module_Ctrl.h"
#include "Module_Const.h"

#include <Oscil.h>               // oscillator template
#include <tables/sin256_int8.h>  // sine table for oscillator
#include <tables/triangle_analogue512_int8.h>
#include <tables/square_no_alias512_int8.h>
#include <tables/saw256_int8.h>
#include <tables/phasor256_int8.h>
#include <tables/halfsin256_uint8.h>
#include <tables/waveshape_chebyshev_4th_256_int8.h>
#include <tables/whitenoise8192_int8.h>
#include <LowPassFilter.h>
#include <ADSR.h>
// #include <tables/sin2048_int8.h>  // sine table for oscillator

#define FUNCTION_LENGTH 10  //总菜单数
#define CONTROL_RATE 128    //控制速率
#define KNOB_PIN 0          //旋钮引脚
#define BTN1_PIN 12         //按钮引脚
#define BTN2_PIN 13         //按钮引脚
#define OUTA_PIN 11         //OUTA引脚
#define IN0_PIN 2           //V OCT
#define IN1_PIN 3           //IN1
#define IN2_PIN 5           //IN2 已经被改造为D11 用于CV输出

Oscil<SIN256_NUM_CELLS, AUDIO_RATE> aSin(SIN256_DATA);
Oscil<SIN256_NUM_CELLS, AUDIO_RATE> aLfo(SIN256_DATA);

Oscil<TRIANGLE_ANALOGUE512_NUM_CELLS, AUDIO_RATE> aTra(TRIANGLE_ANALOGUE512_DATA);
Oscil<SQUARE_NO_ALIAS512_NUM_CELLS, AUDIO_RATE> aSqu(SQUARE_NO_ALIAS512_DATA);
Oscil<SAW256_NUM_CELLS, AUDIO_RATE> aSaw(SAW256_DATA);
Oscil<PHASOR256_NUM_CELLS, AUDIO_RATE> aPha(PHASOR256_DATA);
Oscil<HALFSIN256_NUM_CELLS, AUDIO_RATE> aHSin(HALFSIN256_DATA);
Oscil<WHITENOISE8192_NUM_CELLS, AUDIO_RATE> aNos(WHITENOISE8192_DATA);
LowPassFilter lpf;
ADSR<AUDIO_RATE, AUDIO_RATE> envelope;

int POSITION = 0;  //菜单下标
String function[FUNCTION_LENGTH] = { "Wave", "F_Env", "Pitch", "Vol", "FFreq", "FltQ.", "Attk.", "Decay", "C_M_F", "C_M_A" };
int param[FUNCTION_LENGTH] = { 0, 512, 440, 1024, 972, 128, 0, 1001, 0, 0 };  // 给部分数组元素赋值

bool* ledGroup[FUNCTION_LENGTH] = { CLed1, CLed2, CLed3, CLed4, CLed5, CLed6, CLed7, CLed8, CLed7, CLed8 };

void setup() {
  Serial.begin(115200);                              //使用Serial.begin()函数来初始化串口波特率,参数为要设置的波特率
  initCtrl(KNOB_PIN, 50, BTN1_PIN, BTN2_PIN, HIGH);  //初始化控制参数
  initLED(2, 3, 4, 5, 6, 7, 8);                      //初始化led引脚
  startMozzi(CONTROL_RATE);                          //启动mozzi库
}

int Wave = 0;
int F_E_A = 0;
int F_Env = 0;
int Pitch = 0;
int Vol = 0;
int Cutof = 0;
int Reso = 0;

int C_M_F = 0;
int C_M_A = 0;
void updateControl() {

  POSITION = getPostition(POSITION, FUNCTION_LENGTH);  //获取菜单下标
  param[POSITION] = getParam(param[POSITION]);         //用以注册按钮旋钮控制引脚 并获取修改成功的旋钮值
  displayLED(ledGroup[POSITION]);                      //display  //用以展示控制

  Serial.print(function[POSITION] + param[POSITION]);  //func param
  // for (int ii = 0; ii < 10; ii++) Serial.print("-" + function[ii] + param[ii] + " ");  //func param list
  Serial.println("                  ");

  //在这里修改参数 先将1024转化成具体数值 再设置配置
  Wave = param[0] >> 7;   //波表  将1023分成8个波表类型
  Pitch = param[2] + 20;  //频率调整 20hz-2048hz
  Vol = param[3] >> 3;    //0-256
  Cutof = param[4] >> 2;
  F_Env = (param[1] >> 6) - 8;
  Reso = param[5] >> 2;
  C_M_F = param[8] >> 6;
  C_M_A = param[9] >> 6;
  aLfo.setFreq(C_M_F);

  // //设置滤波器
  // lpf.setCutoffFreq(Cutof);
  // lpf.setResonance(Reso);

  // 设置频率
  int voct = mozziAnalogRead(IN0_PIN) * 1.85;
  int toneFreq = Pitch * pow(2, (pgm_read_float(&(voctpow[voct]))));  // V/oct apply

  switch (Wave) {
    default:
      aSin.setFreq(toneFreq);  //设置频率  // aSin.setFreq(mozziAnalogRead(0));
      break;
    case 1:
      aTra.setFreq(toneFreq);  //设置频率  // aSin.setFreq(mozziAnalogRead(0));
      break;
    case 2:
      aSqu.setFreq(toneFreq);
      break;
    case 3:
      aSaw.setFreq(toneFreq);
      break;
    case 4:
      aPha.setFreq(toneFreq);
      break;
    case 5:
      aHSin.setFreq(toneFreq);
      break;
    case 6:
    case 7:
      aNos.setFreq(toneFreq);
      break;
  }
  //设置包络
  if (param[7] < 1000) {  //如果release大于1000 则启用持续震荡模式
    envelope.setADLevels(255, 255);
    envelope.setTimes(param[6] >> 4, param[7] >> 4, param[7] >> 4, param[7] >> 4);
    // if (mozziAnalogRead(IN1_PIN) > 800) //gate in
    if (digitalRead(13) == 1 || mozziAnalogRead(3) > 800)  //btn Test cltest黑色 飞线定制版
      envelope.noteOn();
    else
      envelope.noteOff();
    envelope.update();
    Vol = envelope.next() * Vol / 255;  // 这就是它与音频速率包络不同的地方
    F_E_A = Vol * F_Env;
    analogWrite(OUTA_PIN, Vol);  //对OUTA_PIN输出pwm
  }
  Serial.println(F_E_A);
}

int updateAudio() {
  // Q15n16 vibrato = (Q15n16)L1A * lfo.next();
  //设置滤波器
  lpf.setCutoffFreq(Cutof + F_E_A + (128 + aLfo.next()) * C_M_A);
  lpf.setResonance(Reso);
  switch (Wave) {
    default:
      return lpf.next((aSin.next() * Vol) >> 8);  // return an int signal centred around 0
      // int oct_cv_val = mozzimozziAnalogRead(IN2_PIN);//这里用v/oct的输入值 用mozzi专用的引脚读取 fm测试
      // return lpf.next(MonoOutput::fromNBit(16, (aSin.phMod(Q15n16(param[11] * oct_cv_val >> 8)) / 2 * Vol)));
    case 1:
      return lpf.next((aTra.next() * Vol) >> 8);
    case 2:
      return lpf.next((aSqu.next() * Vol) >> 8);
    case 3:
      return lpf.next((aSaw.next() * Vol) >> 8);
    case 4:
      return lpf.next((aPha.next() * Vol) >> 8);
    case 5:
      return lpf.next((aHSin.next() * Vol) >> 8);
    case 6:
      // return lpf.next((aCheb.next() * Vol) >> 8);
    case 7:
      return lpf.next((aNos.next() * Vol) >> 8);
  }
}

void loop() {   //这里实时音频处理 尽量不要额外的事情
  audioHook();  //Mozzi required here
}
