lechenghhh/ContourLine/Software/Sampler/sample3.h

#ifndef dongji3_H_
#define dongji3_H_
 
#include <Arduino.h>
#include "mozzi_pgmspace.h"
 
#define dongji3_NUM_CELLS 16478
#define dongji3_SAMPLERATE 4096
 
CONSTTABLE_STORAGE(int8_t) sample3_DATA [] = {9, 29, 7, 28, 7, 27, 8, 28, 10,
30, 14, 33, 18, 36, 21, 39, 24, 41, 25, 42, 25, 42, 24, 42, 23, 40, 22, 39, 20,
38, 19, 37, 19, 37, 18, 36, 18, 36, 17, 35, 16, 35, 14, 33, 12, 31, 10, 29, 7,
26, 5, 23, 2, 20, 0, 18, -2, 16, -3, 15, -3, 14, -3, 14, -3, 14, -2, 14, -2, 14,
-1, 13, -1, 13, -1, 13, -1, 12, -2, 11, -4, 9, -5, 8, -6, 7, -6, 6, -6, 6, -5,
6, -5, 5, -4, 5, -5, 3, -6, 2, -7, -1, -10, -3, -12, -6, -15, -9, -17, -12, -17,
-13, -17, -14, -17, -15, -15, -15, -14, -14, -13, -15, -13, -15, -12, -16, -12,
-17, -11, -17, -9, -16, -7, -14, -5, -12, -3, -11, -3, -10, -4, -10, -6, -12,
-9, -15, -13, -19, -16, -23, -18, -25, -19, -27, -19, -27, -17, -25, -16, -23,
-14, -21, -13, -20, -12, -19, -12, -19, -12, -20, -13, -21, -13, -22, -13, -22,
-13, -22, -12, -22, -11, -21, -9, -19, -7, -17, -5, -16, -2, -13, 1, -11, 3, -9,
6, -7, 8, -5, 10, -4, 11, -2, 12, -1, 14, 2, 16, 5, 19, 9, 23, 13, 26, 17, 29,
21, 30, 23, 30, 24, 29, 24, 26, 22, 23, 19, 21, 17, 20, 17, 22, 17, 24, 20, 29,
23, 33, 27, 37, 30, 40, 33, 42, 35, 42, 35, 40, 34, 38, 32, 36, 31, 34, 29, 33,
28, 33, 28, 33, 28, 33, 28, 32, 27, 31, 26, 28, 24, 25, 21, 21, 18, 16, 14, 12,
10, 8, 5, 4, 2, 1, -2, -1, -4, -3, -7, -4, -10, -5, -12, -5, -14, -5, -16, -5,
-18, -5, -19, -6, -20, -6, -21, -7, -22, -8, -23, -8, -24, -8, -24, -7, -23, -5,
-21, -3, -19, -1, -17, 1, -15, 2, -13, 2, -12, 1, -12, -1, -13, -3, -15, -6,
-17, -9, -19, -10, -20, -11, -21, -11, -21, -10, -21, -10, -21, -9, -21, -9,
-21, -8, -21, -7, -21, -5, -20, -2, -18, 1, -16, 4, -13, 5, -12, 5, -11, 4, -12,
1, -14, -4, -16, -8, -19, -11, -21, -14, -22, -15, -22, -15, -21, -14, -20, -13,
-18, -12, -18, -12, -18, -13, -20, -15, -23, -18, -26, -21, -30, -24, -34, -27,
-37, -30, -40, -32, -42, -33, -44, -34, -45, -34, -45, -33, -45, -32, -44, -30,
-43, -28, -42, -26, -41, -26, -40, -25, -40, -26, -39, -26, -38, -25, -37, -24,
-34, -22, -31, -19, -28, -16, -24, -14, -21, -12, -18, -11, -17, -12, -16, -13,
-17, -15, -17, -16, -17, -16, -16, -14, -14, -11, -11, -8, -7, -4, -2, 0, 1, 3,
5, 5, 7, 6, 9, 7, 10, 7, 11, 7, 12, 7, 14, 7, 16, 8, 19, 9, 21, 9, 23, 10, 25,
10, 25, 9, 25, 8, 24, 6, 23, 4, 21, 3, 20, 2, 19, 1, 19, 1, 19, 0, 19, 0, 20, 0,
20, 0, 20, 1, 21, 2, 22, 3, 24, 4, 25, 5, 27, 6, 28, 6, 29, 6, 29, 5, 29, 5, 29,
5, 29, 5, 29, 5, 29, 5, 30, 5, 30, 4, 30, 3, 29, 0, 28, -2, 26, -5, 24, -8, 22,
-10, 20, -12, 19, -12, 18, -13, 18, -13, 17, -14, 16, -15, 15, -16, 14, -16, 13,
-15, 14, -13, 16, -10, 19, -6, 22, -3, 25, -1, 27, 0, 27, -2, 25, -5, 22, -9,
18, -13, 15, -15, 12, -17, 10, -17, 10, -15, 11, -13, 12, -12, 14, -10, 14, -10,
14, -10, 13, -11, 12, -12, 11, -13, 10, -14, 9, -14, 8, -14, 7, -13, 7, -12, 7,
-10, 7, -7, 8, -4, 10, 0, 12, 4, 13, 7, 15, 10, 16, 11, 17, 13, 17, 13, 17, 14,
17, 16, 17, 18, 19, 21, 21, 24, 23, 27, 26, 29, 27, 29, 27, 28, 25, 26, 22, 23,
19, 20, 15, 18, 13, 18, 11, 19, 11, 21, 12, 23, 13, 25, 15, 27, 15, 28, 15, 28,
15, 28, 13, 27, 12, 27, 10, 26, 8, 26, 6, 26, 6, 26, 5, 25, 4, 25, 4, 23, 3, 21,
1, 18, -2, 15, -5, 11, -9, 7, -12, 3, -16, 0, -19, -2, -22, -4, -25, -6, -27,
-7, -29, -7, -31, -8, -32, -7, -33, -7, -33, -6, -33, -5, -33, -5, -33, -4, -33,
-3, -32, -2, -32, 0, -30, 2, -28, 6, -25, 9, -22, 13, -17, 17, -13, 19, -9, 21,
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
 };

#endif /* dongji3_H_ */
