lechenghhh/ContourLine/Software/Sampler/sample4.h

#ifndef sample4_H_
#define sample4_H_
 
#include <Arduino.h>
#include "mozzi_pgmspace.h"
 
#define sample4_NUM_CELLS 8286
#define sample4_SAMPLERATE 16384
 
CONSTTABLE_STORAGE(int8_t) sample4_DATA [] = {33, 51, 35, 51, 37, 50, 36, 49,
39, 47, 42, 48, 43, 52, 43, 51, 41, 46, 41, 47, 43, 48, 44, 47, 44, 46, 46, 46,
43, 44, 41, 44, 44, 41, 45, 41, 45, 42, 46, 39, 50, 39, 52, 42, 51, 42, 49, 40,
51, 37, 51, 34, 50, 34, 50, 35, 51, 35, 52, 34, 53, 37, 49, 38, 45, 36, 47, 33,
48, 29, 43, 31, 41, 29, 40, 27, 38, 27, 37, 26, 35, 22, 35, 18, 31, 17, 28, 19,
32, 21, 31, 22, 30, 22, 29, 21, 28, 22, 25, 21, 22, 21, 18, 27, 16, 25, 20, 23,
19, 24, 15, 25, 15, 27, 15, 28, 14, 29, 13, 33, 13, 39, 16, 34, 13, 30, 13, 33,
17, 37, 19, 38, 15, 39, 15, 40, 18, 40, 20, 43, 23, 44, 21, 45, 23, 45, 27, 43,
27, 42, 27, 42, 31, 43, 36, 43, 38, 42, 36, 40, 39, 42, 42, 47, 41, 41, 43, 34,
46, 34, 46, 38, 43, 36, 42, 34, 43, 33, 43, 32, 44, 30, 43, 27, 41, 27, 39, 29,
36, 28, 36, 28, 37, 29, 37, 26, 38, 25, 36, 22, 38, 22, 38, 25, 31, 27, 26, 24,
29, 20, 29, 21, 23, 22, 18, 21, 16, 16, 16, 12, 15, 12, 14, 10, 12, 6, 9, 4, 7,
4, 5, 1, 2, -2, 2, -1, 4, -1, 6, -3, 6, -4, 3, -5, -4, -8, -4, -8, 0, -10, -1,
-10, -4, -9, -5, -6, -5, -6, -3, -6, -3, -3, -6, 0, -5, 3, -3, 4, 0, 5, 3, 12,
5, 11, 4, 10, 7, 14, 7, 16, 11, 17, 13, 19, 10, 23, 11, 26, 12, 30, 15, 32, 17,
32, 19, 32, 21, 34, 22, 37, 23, 40, 23, 39, 26, 36, 29, 36, 28, 36, 29, 36, 28,
37, 26, 33, 26, 28, 29, 27, 31, 28, 31, 25, 31, 21, 28, 18, 25, 17, 25, 17, 25,
13, 21, 10, 20, 10, 21, 8, 21, 7, 22, 9, 22, 6, 18, 3, 14, 3, 14, 3, 15, 4, 13,
5, 10, 2, 9, -1, 8, 1, 5, 1, 6, -1, 7, -3, 2, -4, 3, -3, 3, 3, -3, 5, -2, 4, 1,
5, 3, 6, 0, 7, 0, 12, 4, 13, 5, 10, 6, 13, 6, 17, 9, 18, 8, 20, 9, 20, 10, 20,
9, 26, 10, 26, 13, 22, 14, 24, 15, 27, 15, 29, 16, 31, 20, 28, 20, 25, 19, 28,
22, 30, 28, 27, 36, 29, 35, 31, 28, 30, 30, 30, 36, 31, 39, 29, 37, 31, 33, 30,
33, 24, 33, 22, 34, 23, 32, 18, 30, 17, 28, 20, 28, 20, 25, 18, 24, 20, 25, 20,
26, 22, 30, 19, 33, 15, 28, 19, 21, 19, 22, 19, 26, 17, 20, 10, 17, 7, 18, 6,
20, 4, 18, 7, 12, 14, 11, 16, 14, 13, 10, 13, 11, 16, 15, 19, 14, 17, 16, 16,
13, 21, 15, 20, 24, 13, 23, 10, 16, 13, 16, 18, 14, 15, 10, 12, 10, 12, 12, 12,
16, 15, 15, 16, 12, 12, 12, 13, 15, 16, 9, 13, 6, 14, 9, 17, 6, 17, 4, 18, 0,
21, -2, 28, 1, 30, 2, 23, -2, 15, -2, 17, -2, 18, -5, 13, -7, 16, -7, 20, -5,
20, -3, 18, -1, 17, 5, 13, 6, 14, -1, 20, 2, 15, 8, 7, 14, 6, 12, 5, 8, 3, 12,
6, 18, 7, 21, 8, 17, 5, 15, 0, 15, 7, 15, 6, 9, 0, 9, 1, 12, 3, 12, 0, 12, -3,
12, -5, 5, -8, -2, -7, 0, -5, -1, -10, -2, -11, 0, -5, 0, 1, 1, -2, -2, -11, -8,
-17, -12, -16, -13, -16, -15, -18, -14, -18, -19, -21, -20, -24, -16, -23, -16,
-21, -21, -24, -14, -24, -12, -15, -18, -12, -17, -14, -17, -13, -17, -14, -17,
-9, -16, -2, -15, -4, -18, -5, -17, -5, -14, -4, -12, -2, -10, -4, -9, -6, -11,
-3, -11, 0, -8, -2, -7, 1, -9, 4, -6, 1, -3, 2, -7, 4, -7, 5, -5, 6, -8, 3, -12,
0, -12, 0, -12, -2, -12, 1, -13, 4, -8, 3, -7, 1, -12, 0, -7, -1, -6, -9, -5,
-8, -6, -8, -10, -13, -11, -14, -12, -16, -14, -18, -13, -17, -15, -19, -15,
-19, -13, -19, -19, -22, -20, -28, -21, -30, -21, -32, -23, -31, -23, -25, -27,
-25, -34, -36, -34, -36, -36, -36, -38, -42, -37, -42, -34, -43, -32, -42, -31,
-41, -37, -42, -38, -40, -41, -45, -43, -48, -37, -46, -41, -47, -41, -42, -36,
-42, -41, -44, -45, -43, -37, -41, -34, -40, -39, -41, -40, -45, -39, -43, -40,
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

#endif /* sample4_H_ */
