lechenghhh/ContourLine/Software/Sampler/sample2.h

#ifndef sample2_H_
#define sample2_H_
 
#include <Arduino.h>
#include "mozzi_pgmspace.h"
 
#define sample2_NUM_CELLS 24000
#define sample2_SAMPLERATE 4096
 
CONSTTABLE_STORAGE(int8_t) sample2_DATA [] = {1, 0, 9, 0, 16, 0, 24, 0, 31, 0,
39, 0, 46, 0, 52, 0, 58, -1, 64, 0, 70, 0, 75, 0, 79, 0, 84, 0, 87, -1, 90, 0,
92, -1, 93, 0, 93, 0, 92, 0, 89, -1, 86, 0, 83, -1, 79, 0, 74, 0, 69, -1, 64, 0,
59, -1, 54, 0, 49, -1, 45, 0, 40, -1, 35, 0, 30, -1, 24, 0, 19, 0, 13, -1, 6, 0,
-1, -1, -8, 0, -15, -1, -21, 0, -26, 0, -31, 0, -35, 0, -40, 0, -43, -1, -47, 0,
-51, -1, -54, 0, -57, 0, -60, 0, -62, -1, -64, 0, -65, -1, -67, 0, -68, 0, -69,
-1, -70, 0, -70, 0, -70, -1, -69, 0, -69, 0, -69, -1, -69, 0, -68, -1, -67, 0,
-66, -1, -64, 0, -62, 0, -59, -1, -57, 0, -55, -1, -53, 0, -51, -1, -49, 0, -48,
-1, -46, 0, -45, -1, -44, 0, -43, -1, -41, 0, -40, -1, -39, 0, -37, -1, -35, 0,
-33, -1, -29, 0, -26, 0, -21, -1, -16, 0, -10, -1, -3, 0, 4, -1, 12, 0, 19, -1,
27, 0, 34, -1, 40, 0, 46, -1, 50, 0, 54, -1, 58, 0, 61, 0, 63, -1, 65, 0, 67,
-1, 69, 0, 70, -1, 70, 0, 70, 0, 68, -1, 66, 0, 63, 0, 59, -1, 54, 0, 49, -1,
43, 0, 36, -1, 29, 0, 22, -1, 14, 0, 7, -1, 1, 0, -5, -1, -10, 0, -15, -1, -19,
0, -23, 0, -27, -1, -31, 0, -34, -1, -37, 0, -40, -1, -43, 0, -44, -1, -45, 0,
-46, 0, -45, 0, -45, 0, -44, -1, -43, 0, -42, -1, -41, 0, -40, 0, -40, -1, -39,
0, -39, -1, -38, 0, -38, -1, -39, 0, -39, 0, -39, -1, -39, 0, -39, -1, -39, 0,
-40, 0, -40, 0, -41, -1, -41, 0, -43, -1, -44, 0, -46, 0, -48, 0, -51, 0, -53,
-1, -55, 0, -56, -1, -58, 0, -59, -1, -60, -1, -60, 0, -61, -1, -62, 0, -63, -1,
-65, 0, -66, -1, -67, 0, -67, -1, -66, 0, -65, 0, -62, 0, -60, 0, -57, 0, -54,
-1, -51, 0, -46, -1, -41, 0, -35, -1, -28, 0, -21, 0, -13, 0, -5, -1, 3, 0, 10,
0, 17, -1, 24, 0, 31, -1, 37, 0, 42, -1, 47, 0, 51, 0, 55, -1, 58, 0, 61, -1,
62, -1, 63, 0, 64, -1, 63, 0, 62, -1, 60, 0, 57, -1, 54, 0, 49, 0, 44, -1, 39,
0, 34, -1, 30, 0, 27, 0, 25, 0, 23, 0, 22, 0, 21, -1, 21, 0, 21, 0, 21, 0, 21,
0, 20, -1, 19, 0, 17, -1, 15, 0, 12, 0, 9, -1, 7, 0, 6, -1, 5, 0, 6, -1, 7, 0,
8, 0, 10, -1, 11, 0, 11, -1, 12, 0, 12, 0, 11, -1, 10, 0, 9, -1, 7, 0, 5, -1, 3,
0, 1, -1, -1, 0, -3, -1, -5, 0, -7, 0, -10, 0, -13, 0, -17, 0, -20, 0, -23, -1,
-26, 0, -29, -1, -31, 0, -32, -1, -33, 0, -34, 0, -34, -1, -34, 0, -34, -1, -34,
0, -34, -1, -34, 0, -34, 0, -33, -1, -33, 0, -32, -1, -31, 0, -30, -1, -28, 0,
-26, 0, -24, 0, -22, 0, -19, -1, -16, 0, -13, -1, -10, 0, -6, -1, -3, 0, 0, 0,
3, -1, 7, 0, 10, -1, 13, 0, 16, 0, 19, -1, 22, 0, 25, 0, 28, -1, 31, 0, 34, 0,
38, -1, 41, 0, 43, -1, 45, 0, 45, 0, 45, -1, 44, 0, 43, -1, 40, 0, 38, -1, 35,
0, 32, 0, 30, -1, 27, 0, 25, -1, 24, 0, 23, -1, 23, 0, 23, 0, 23, 0, 24, -1, 25,
0, 26, -1, 27, 0, 27, 0, 28, -1, 27, 0, 26, -1, 25, 0, 24, 0, 23, -1, 21, 0, 19,
0, 18, -1, 16, 0, 15, 0, 13, -1, 12, 0, 10, 0, 9, -1, 7, 0, 5, -1, 3, 0, 0, -1,
-2, 0, -4, 0, -6, -1, -8, 0, -10, 0, -11, -1, -12, 0, -13, 0, -14, -1, -16, 0,
-18, -1, -20, 0, -23, 0, -27, 0, -31, 0, -34, -1, -38, 0, -40, -1, -42, 0, -42,
-1, -42, 0, -42, -1, -41, 0, -40, -1, -39, 0, -38, -1, -36, 0, -34, -1, -31, 0,
-28, 0, -24, -1, -20, 0, -16, -1, -12, 0, -7, -1, -2, 0, 2, -1, 7, 0, 12, -1,
16, 0, 19, -1, 22, 0, 25, 0, 28, 0, 31, -1, 35, 0, 39, -1, 43, 0, 48, -1, 53, 0,
57, 0, 61, -1, 64, 0, 65, -1, 66, 0, 65, -1, 64, 0, 62, -1, 60, 0, 57, -1, 54,
0, 50, -1, 45, 0, 39, 0, 34, -1, 28, 0, 22, -1, 17, 0, 11, -1, 6, 0, 1, -1, -3,
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

0, 39, 0, };

#endif /* sample2_H_ */
