lechenghhh/ContourLine/(commit log)

2023-05-25 修改日志格式
2023-06-20 三功能dco上传
2023-06-20 修复参数乱跳的bug
2023-06-21 增加包络触发声音 增加调频(暂未启用）
2023-06-21 增加注释
2023-06-21 将双包络案例删减为单包洛
2023-06-21 整理eg模块封装
2023-06-21 整理封装代码
2023-06-21 增加包络输出功能
2023-06-22 不采用simpleEG的输出 采用mozzi的lv包络输出
2023-06-25 修改变量
2023-06-25 修改包络输出引脚
2023-06-25 优化控制代码封装
2023-06-25 修改控制封装
2023-06-28 修复引脚冲突导致d13不能按钮输入
2023-06-28 去掉eg生成的模块
2023-06-28 优化控制代码初始化
2023-07-08 增加CLTest版本 供旧的硬件使用 Signed-off-by: lc-hp <951827860@qq.com>
2023-07-08 增加CLTest版本 供旧的硬件使用2 Signed-off-by: lc-hp <951827860@qq.com>
2023-07-08 修改GATE引脚 测试Gate触发声音成功 Signed-off-by: lc-hp <951827860@qq.com>
2023-07-09 FullFuncDCO可以voct了 增加testMozzianalogread Signed-off-by: lc-hp <951827860@qq.com>
2023-07-09 增加FM测试类 需要改造成CL1.0支持的引脚和控制逻辑 Signed-off-by: lc-hp <951827860@qq.com>
2023-07-09 CLTest 更新显示 并且支持voct Signed-off-by: lc-hp <951827860@qq.com>
2023-07-09 完善FmVco使之支持CLTest Signed-off-by: lc-hp <951827860@qq.com>
2023-07-09 增加数码管说明 Signed-off-by: lc-hp <951827860@qq.com>
2023-07-10 完善FmDCO使之支持CLTest
2023-07-10 备份eg生成模块
2023-07-10 增加波表合成测试
2023-07-10 优化整理fmDCO代码
2023-07-10 修改显示
2023-07-10 增加上翻页功能
2023-07-10 优化点击事件 Signed-off-by: lc-hp <951827860@qq.com>
2023-07-11 波表合成器支持cltest
2023-07-11 168p运行异常 优化存储 Signed-off-by: lc-hp <951827860@qq.com>
2023-07-13 优化修改目录结构
2023-07-13 增加可调制eg的filter
2023-07-13 测试input失败
2023-07-13 修改cltest专用dco
2023-07-16 增加调谐系数 是voct准确 Signed-off-by: lc-hp <951827860@qq.com>
2023-07-16 增加针对的测试硬件版本 Signed-off-by: lc-hp <951827860@qq.com>
2023-07-16 修改调谐系数 Signed-off-by: lc-hp <951827860@qq.com>
2023-07-16 优化波表振荡器存储 Signed-off-by: lc-hp <951827860@qq.com>
2023-07-17 修改voct系数
2023-07-17 增加glitch synth相关代码
2023-07-18 修改包络触发逻辑
2023-07-19 修改变量名称
2023-07-19 增加实物图
2023-07-19 LFO构想
2023-07-19 量化器构想
2023-07-19 增加触发模式
2023-07-19 实现部分lfo功能
2023-07-19 量化器搬运hagiwo 还未改造
2023-07-19 更新说明 构想
2023-07-20 wtDCO mozA3 read 使用位置修改 Signed-off-by: lc-hp <951827860@qq.com>
2023-07-21 修复bug analgoread Signed-off-by: lc-hp <951827860@qq.com>
    [EGFilter.ino]
2023-07-22 元件说明图 Signed-off-by: lc-hp <951827860@qq.com>
2023-07-24 dco的默认音量都开满
2023-07-25 DCO优化原有逻辑
2023-07-25 增加fm调制功能 调制区间还未完善 但是很好玩 Signed-off-by: lc-hp <951827860@qq.com>
2023-07-28 优化fm算法
2023-07-28 优化算法
2023-07-28 波表 调频功能完善 Signed-off-by: lc-hp <951827860@qq.com>
2023-10-16 支持到cl1.0
2023-10-17 增加一个菜单
2023-10-26 第二代fmdco增加多种波型 Signed-off-by: lecheng <lechenggood@foxmail.com>
2023-11-09 使全功能版fm振荡器具备波表切换、波形渐变的功能
2023-11-09 d11作为波表切换触发引脚 Signed-off-by: lecheng <lechenggood@foxmail.com>
2023-11-09 波表循环功能 还未完善 Signed-off-by: lecheng <lechenggood@foxmail.com>
2023-11-09 波表循环逻辑优化 Signed-off-by: lecheng <lechenggood@foxmail.com>
2023-11-09 更换波形变化表 Signed-off-by: lecheng <lechenggood@foxmail.com>
2023-11-10 整理代码 增加led显示等逻辑 增加部分波表 Signed-off-by: lecheng <lechenggood@foxmail.com>
2023-11-10 增加十六种波形 Signed-off-by: lecheng <lechenggood@foxmail.com>
2023-11-30 修改为支持cl1.0的引脚
2023-11-30 增加说明
2023-11-30 for cl1.0 修改回引脚
2023-12-08 修改目录结构 Signed-off-by: lecheng <lechenggood@foxmail.com>
2023-12-08 增加说明文件 修改文件目录 Signed-off-by: lecheng <lechenggood@foxmail.com>
2023-12-11 增加168p fmwswtdco Signed-off-by: lecheng <lechenggood@foxmail.com>
2023-12-11 修改波表顺序 Signed-off-by: lecheng <lechenggood@foxmail.com>
2024-03-29 增加开源资料 Signed-off-by: lecheng <lechenggood@foxmail.com>
    [BOM_ContourLine2.1_ContourLine2.1_2024-03-29.xlsx]
2024-03-29 修改说明文件 Signed-off-by: lecheng <lechenggood@foxmail.com>
2024-03-29 更新主界面readme
2024-03-29 修改readme格式 Signed-off-by: lecheng <lechenggood@foxmail.com>
2024-03-29 优化readme格式 Signed-off-by: lecheng <lechenggood@foxmail.com>
2024-04-01 增加tripledco说明 Signed-off-by: lecheng <lechenggood@foxmail.com>
2024-04-01 修复缺少gate pin的问题 Signed-off-by: lecheng <lechenggood@foxmail.com>
    [Module_Ctrl.h]
2024-04-02 修改说明文档格式 以及标注作者 Signed-off-by: lecheng <lechenggood@foxmail.com>
2024-04-02 fm合成器备份 调整新版引脚 Signed-off-by: lecheng <lechenggood@foxmail.com>
2024-04-02 增加版本文件夹 Signed-off-by: lecheng <lechenggood@foxmail.com>
    [BOM_ContourLine2.1_ContourLine2.1_2024-03-29.xlsx]
2024-04-02 修复波形切换功能
2024-04-03 增加168p专用 Signed-off-by: lecheng <lechenggood@foxmail.com>
2024-04-03 优化fmwswtdco代码以及介绍 Signed-off-by: lecheng <lechenggood@foxmail.com>
2024-04-03 删除无用文件 Signed-off-by: lecheng <lechenggood@foxmail.com>
2024-04-03 采用单振荡器 多波表设置 旧的采用不同波表多个振荡器 Signed-off-by: lecheng <lechenggood@foxmail.com>
2024-04-03 和谐音程振荡器 Signed-off-by: lecheng <lechenggood@foxmail.com>
2024-04-03 调整波形以及顺序 Signed-off-by: lc-hp <951827860@qq.com>
2024-04-03 波形排列优化 Signed-off-by: lc-hp <951827860@qq.com>
2024-04-07 增加加法音程算法 Signed-off-by: lecheng <lechenggood@foxmail.com>
2024-04-07 增加打击乐合成器 Signed-off-by: lecheng <lechenggood@foxmail.com>
2024-04-07 增加说明手册 增加触发接口定义 Signed-off-by: lecheng <lechenggood@foxmail.com>
2024-04-07 修复鼓模块bug Signed-off-by: lc-hp <951827860@qq.com>
2024-04-07 新增音频接口功能说明
2024-04-08 音色调整 说明更新
2024-04-08 增加打击乐音量调整功能
2024-04-08 增加粒子功能测试 Signed-off-by: lecheng <lechenggood@foxmail.com>
2024-04-08 增加粒子合成器模块 Signed-off-by: lecheng <lechenggood@foxmail.com>
2024-04-08 增加颗粒合成器说明 Signed-off-by: lecheng <lechenggood@foxmail.com>
2024-04-09 修复hat触发无效的bug Signed-off-by: lecheng <lechenggood@foxmail.com>
2024-04-09 粒子合成器功能完成
2024-04-09 优化粒子合成器模块led简易显示
2024-04-09 修复背面旋钮的引脚说明
2024-04-10 增加粒子合成器diffusion功能
2024-04-10 修改项目名称
2024-04-10 修复fm合成器错误
2024-04-10 优化triple操作模式 显示更直接 Signed-off-by: lecheng <lechenggood@foxmail.com>
2024-04-10 更新fmwswtdco 168说明 Signed-off-by: lecheng <lechenggood@foxmail.com>
2024-04-10 修改项目名为:FmAddChordDCO
2024-04-10 新增合成器功能链接
2024-04-10 修改合成器功能说明
2024-04-11 优化rim触发机制
2024-04-12 优化代码顺序 增加w led显示
2024-04-16 增加波形类型与算法说明
2024-04-23 优化文档格式简洁内容 Signed-off-by: lecheng <lechenggood@foxmail.com>
2024-04-25 尝试修改fm倍频
2024-04-25 倍频算法预留 Signed-off-by: lecheng <lechenggood@foxmail.com>
2024-04-25 增加cv2控制 Signed-off-by: lecheng <lechenggood@foxmail.com>
2024-04-26 增加压控参数
2024-05-06 修改说明 Signed-off-by: lecheng <lechenggood@foxmail.com>
2024-05-06 修改文件名大小写 Signed-off-by: lecheng <lechenggood@foxmail.com>
2024-05-09 增加音高频率对照表 Signed-off-by: lecheng <lechenggood@foxmail.com>
2024-06-05 更新底鼓的下潜速率
2024-06-05 coutourline2.2版本更新上传 Signed-off-by: lecheng <lechenggood@foxmail.com>
    [BOM_ContourLine2.2 4HP_ContourLine2.2 4HP_2024-06-05.xlsx]
2024-06-06 修复原版chord dco错误
2024-06-07 优化故障振荡器的适配程度 增加说明文档
2024-06-07 更新硬件资料降低构建难度
    [BOM_ContourLine2.2 4HP_ContourLine2.2 4HP_2024-06-05.xlsx, BOM_ContourLine2.2 4HP_ContourLine2.2 4HP_2024-06-07.xlsx]
2024-06-11 加法振荡器适配 Signed-off-by: lecheng <lechenggood@foxmail.com>
2024-06-12 删除无用代码 增加波表 分离voct数据
2024-06-12 兼容至mozzi2.0规范
2024-06-12 精简和谐音程振荡器
2024-06-12 增加每个泛音增益手动控制 Signed-off-by: lecheng <lechenggood@foxmail.com>
2024-06-17 修复杂音输出问题 但是voct还未解决
2024-06-17 删除第五个振荡器 Signed-off-by: lecheng <lechenggood@foxmail.com>
2024-06-19 增加不同波形的和谐震荡器组合 增加d11随机wavetype触发功能
2024-06-19 说明文档更新 Signed-off-by: lecheng <lechenggood@foxmail.com>
2024-06-19 更新文档说明 Signed-off-by: lecheng <lechenggood@foxmail.com>
2024-06-21 提升一些可调范围
2024-06-21 增加噪音波表 Signed-off-by: lecheng <lechenggood@foxmail.com>
2024-06-21 减少sin的占用采用1024 Signed-off-by: lecheng <lechenggood@foxmail.com>
2024-06-24 修复之前非半音间隔问题 因此现在可以调成任何和弦 Signed-off-by: lecheng <lechenggood@foxmail.com>
    [HarmonicOSC.ino]
2024-06-26 修改颠倒按钮 Signed-off-by: lecheng <lechenggood@foxmail.com>
2024-06-27 将基音修改为c1
2024-06-27 chord fm修改新的基音32.7hz 修复chord旋钮最小值时无声 Signed-off-by: lecheng <lechenggood@foxmail.com>
    [org.ino, org_change.ino]
2024-06-27 优化基础fm合成器的基音 优化算法
2024-06-27 优化基音为32.7hz Signed-off-by: lecheng <lechenggood@foxmail.com>
2024-06-27 再次调整基音为c1
2024-06-28 Swarmduino 模块适配改进
2024-06-28 增加三个案例 删除旧的无用案例
2024-07-05 更新文件
    [BOM_ContourLine2.2 4HP_ContourLine2.2 4HP_2024-06-07.xlsx]
2024-07-09 增加波形选择功能
2024-07-09 更新面板参数
2024-07-12 优化WS算法 当调制值为0时 不进行波形渐变的计算
2024-07-20 更新bom 更新gbr
    [BOM_ContourLine2.2 4HP_ContourLine2.2 4HP_2024-06-07.xlsx]
2024-07-22 修改目录名称 增加6knobsynth
2024-07-22 更新bom r25为47k Signed-off-by: lecheng <lechenggood@foxmail.com>
    [BOM_ContourLine2.2 4HP_ContourLine2.2 4HP_2024-06-07.xlsx]
2024-07-24 和谐音程振荡器说明更新 Signed-off-by: lecheng <lechenggood@foxmail.com>
2024-07-24 和谐音程振荡器说明更新2 Signed-off-by: lecheng <lechenggood@foxmail.com>
2024-07-24 各个说明文件增加演示地址
2024-07-24 增加首页入口 Signed-off-by: lecheng <lechenggood@foxmail.com>
2024-07-24 优化程序控制速率
2024-07-29 循环采样器 Signed-off-by: lecheng <lechenggood@foxmail.com>
2024-07-29 增加bitcrush参数
2024-07-29 修改说明显示 Signed-off-by: lecheng <lechenggood@foxmail.com>
2024-07-29 增加四种采样选择
2024-07-29 增加one shot模式 Signed-off-by: lecheng <lechenggood@foxmail.com>
2024-07-29 增加压控能力 颠倒上下按钮
2024-07-29 整理归纳bom表与gbr
    [BOM_ContourLine2.2 4HP_ContourLine2.2 4HP_2024-06-07.xlsx, BOM_ContourLine2.2 4HP_ContourLine2.2 4HP_2024-07-29.xlsx]
2024-07-29 更新实物图
2024-07-30 上传3个sample 增加采样生成器
2024-07-30 sample2 完善
2024-07-30 优化rm
2024-07-30 增加loop length最小间隙
2024-07-30 修改第一个菜单为频率
2024-07-31 补充说明
    [BOM_ContourLine2.2 4HP_ContourLine2.2 4HP_2024-07-29.xlsx]
2024-08-09 补充数码管共阳信息 Signed-off-by: lecheng <lechenggood@foxmail.com>
    [BOM_ContourLine2.2 4HP_ContourLine2.2 4HP_2024-07-29.xlsx]
2024-08-21 优化和谐音程振荡器显示逻辑
2024-08-21 修改w的显示 Signed-off-by: lecheng <lechenggood@foxmail.com>
2024-09-05 优化Readme文件格式 Signed-off-by: lc-starnet <951827860@qq.com>
2024-09-05 Synao 鼓模块上传 Signed-off-by: lc-starnet <951827860@qq.com>
2024-09-09 修复add chord 参数混淆的问题
2024-09-10 增加风噪音模块
2024-09-10 增加6旋钮说明 增加pluck模块 还没开始 Signed-off-by: lc-starnet <951827860@qq.com>
2024-09-10 无法增加参数 失败
2024-09-11 修改代码位置
2024-09-11 增加analogwave 虚拟模拟振荡器 Signed-off-by: lc-starnet <951827860@qq.com>
2024-09-11 增加音飘功能 Signed-off-by: lc-starnet <951827860@qq.com>
2024-09-13 修改项目名称 增加总说明 Signed-off-by: lecheng <951827860@qq.com>
2024-09-14 弹拨振荡器
2024-09-20 统一修改所有参数长度为：PARAM_LENGTH
2024-09-27 采用新的rangetype计算方法
2024-11-21 测试JohnSynth_V6合成器
2024-12-02 增加包络例子
2024-12-06 增加glitch开关 用于开启随机功能
2025-03-01 FmDco 增加内置算子包络 增加调制逻辑
2025-03-02 FMDCO 增加兼容lgt8f328p
2025-03-06 修改目录结构
2025-03-19 FMdco 尝试将音频采样率提升至32k
2025-03-21 FMDCO 提升波形精度到2048 Signed-off-by: 951827860@qq.com <951827860@qq.com>
2025-04-07 AnalogWave 增加压控衰减器
2025-04-07 暂时禁用衰减
2025-04-07 AnalogWave 增加sync功能 增加wavetype cv能力
2025-04-07 更新lfo模式
2025-04-08 AnalogWave 更新voct与octave逻辑
2025-04-08 减少chord爆音问题
2025-04-12 FMDCO 优化fm amount区间
